scientistnobee/LightDx/caspule_board.jpeg

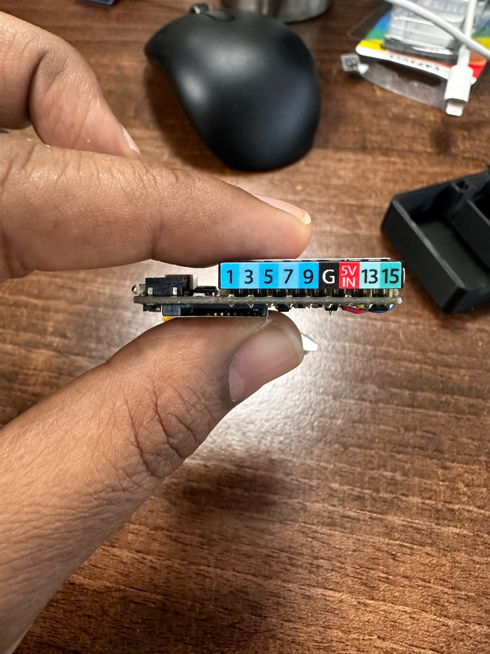
caspule_board.jpeg
