scientistnobee/LightDx/battery1.jpeg

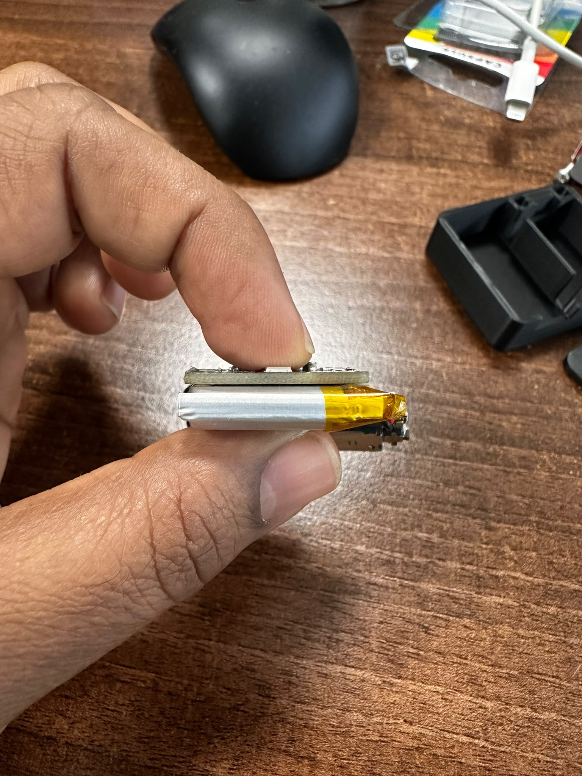
battery1.jpeg
