scientistnobee/LightDx/README.md

# LightDx
Its about wearable spectral sensor
