scientistnobee/LightDx/LightDx_slim_puck_design.html

# LightDx puck: slim, normal v4 and wearable

Design page, 2026-10-15, updated 2026-10-16: sections 6 (normal puck v4, connectors kept) and 7 (wearable strap base) are new; sections 1 to 5 describe the slim puck (second print worked well, frozen as LightDx_base_v1.FCStd, tag base-v1). Renders are FreeCAD views of the saved model Square_puck_v2.FCStd (Slim_Base, Slim_Lid); the STLs in the folder match it, and the state is committed to GitHub (tag slim-puck-print2). Heights are still the old estimates (12.7 mm total). Measurements are the user's caliper readings from 2026-10-15.

## Changes since the first print (2026-10-15, including the second-print feedback)

Item | First printed version | Current model | Why
Box length (X) | 42.4 mm | 40.4 mm | 2 mm spare along X beside the Capsule: 1 mm shaved off each end
Capsule pocket length | 40.4 mm | 38.4 mm | same; USB-C connector now pokes about 1.5 mm further into its window
Box width (Y), Capsule / battery pocket width | 50.0 / 24.4 / 20.4 mm | 50.6 / 24.4 / 21.0 mm | the 2 mm spare was in X, so the Capsule width is unchanged; the battery pocket got +0.6 mm for wires and tape
USB-C window height | centre z 5.7 mm | centre z 6.9 mm (+1.2) | connector sat higher than the window
Diffuser seat diameter | 11.2 mm | 12.0 mm | printed too small; 12.4 was then 0.4 mm too big
G42 pusher nub and tongue | nub at (18.2, 8.4) | (16.2, 10.7): 2 mm left, 3 mm up | lid photo (2 mm left, 2 mm up), then second print: 1 mm further up and a 1.5 mm shorter nub (bottom z 7.5, was 6.0)
Lid power-LED opening | round hole dia 2.0 at (15.2, 8.5) | slit 1.6 x 3.4 (long in Y) at (13.2, 10.7) | user: USB-C-like slit, centred on the tongue in Y (y 10.7, same as the nub)
Far-wall RGB LED window | y 15.2 | y 16.7, centre z 4.9 (was 3.4) | second print: 1 mm down in Y, 1.5 mm up in height (BOOT-to-RGB spacing is now 6.4 mm; 6.0 measured)
Far-wall BOOT hole | y 8.4 | y 10.3 | second print: 1 mm up in Y
Height | 12.7 mm | 12.7 mm (unchanged) | heights worked well

The second-print changes are not printed yet. Screw blocks at the X ends are now 5.75 mm wide, so a small screw head is needed (the 4.4 mm counterbore leaves about 0.7 mm to the outside). y values are in the figure frame of section 4 (box centre = 0); the printed box is drawn dashed there.

## 1. Measured parts

Part | Measured (2026-10-15) | Model used until now
Capsule board (headers incl., no shell) | 6 mm tall | 7 mm (estimate)
Battery alone | 4.5 mm | 6 mm (602025 nominal)
AS7341 board, connectors removed | 2.5 mm | 2.8 mm (pocket 3.0)
Battery + AS7341 stacked | 7 mm tall, 25 mm long, 20 mm wide | 6 + 0.5 gap + 3.0 = 9.5 tall; pocket 27.9 x 20.4

Capsule board, battery and AS7341 laid out on a table

Capsule underside (SD slot, USB-C, side switch at the end), battery and the AS7341 wired to it.

Battery and AS7341 stacked, held between two fingers

Battery + AS7341 stack seen from the side: the 7 mm figure.

Capsule board from the side with header labels

Capsule board from the side: PCB with the labelled header strip on top, SD/USB parts underneath. 6 mm overall.

## 2. Height: what the new numbers change

Left pair: the AS7341-over-battery stack (it sets the box height). Right pair: the Capsule side, which has spare depth. Clearances of 0.3 mm are proposed values, not measured.

Dimension | Built (exported STLs) | Proposed with measured parts
Total height | 12.7 mm (base 10.7 + lid 2.0) | about 10.5 mm (base 8.5 + lid 2.0)
Sensor stack under the lid | 9.5 mm (cell 6 + gap 0.5 + AS7341 pocket 3) | 7.3 mm (7.0 stack + 0.3)
Capsule pocket depth | 10.2 mm (7.0 + 3.2 spare) | 7.3 mm (6.0 + 1.3 spare)
Battery + AS7341 pocket | 27.9 x 21.0 | 25.8 x 20.4 (25 + 0.8, 20 + 0.4)
Footprint | 40.4 x 50.6 (printed 42.4 x 50.0) | 40.4 x 50.6 (proposal keeps this)

Check before rebuilding: the Adafruit AS7341 board is 25.4 mm long, slightly more than the 25 mm you measured for the stack. I would keep the pocket at 25.8 mm so the board fits either way. Not rebuilt yet: the STLs are unchanged.

## 3. Renders of the exported model

Assembled slim puck, front-left view

Assembled, 40.4 x 50.6 x 12.7 mm. Diffuser seat dia 12.0 mm; G42 button tongue and power-LED hole in the lid.

Assembled slim puck from above

Top view of the assembled box.

Base with Capsule, battery and AS7341 envelopes

Base with part envelopes: green = Capsule (40 x 24 x 7), blue = battery (27.5 x 20 x 6), orange = AS7341 board held by four lid pins above the cell.

Base from above with part envelopes

Base, plan: Capsule pocket (top), battery + AS7341 pocket (bottom), divider with the two cable notches at x = -11 and +11.

Lid from above

Lid, top: diffuser seat and the U-slot tongue over the G42 button.

Lid from below

Lid, underside: four base-screw posts, four AS7341 pillars with pins, and the button nub.

USB end of the box

USB-C end (-X): 9.4 x 3.8 mm window.

Far end of the box

Far end (+X): RGB LED window and BOOT hole (positions estimated).

## 4. Plan with X and Y axes (current model vs first print)

Looking down on the base. X runs left to right (USB end at -X, far end at +X), Y runs bottom to top (battery/AS7341 side at -Y, Capsule side at +Y). Origin is the box centre; all positions in mm. In this figure "horizontal" = X and "vertical" = Y.

## 5. Feature list and status

Feature | Value | Status
Outline, height | 40.4 x 50.6 x 12.7 mm; floor 1.2, lid 2.0, end walls 1.0, side walls 2.0 | built
Capsule pocket | 38.4 x 24.4 (battery pocket 27.9 x 21.0); USB-C connector should now stick out about 1.5 mm past the front wall (it touched the wall in the print) | built
USB-C window | 9.4 x 3.8, centre z 6.9 (raised 1.2 after the print) | height to verify
AS7341 retention | 4 lid pins, 2.0 mm, no screws | fit to verify
Diffuser seat | dia 12.0 (was 11.2, then 12.4), 1.5 deep; aperture dia 10; rim under the diffuser 0.5 thick. The diffuser is 2.0 mm thick, so it stands 0.5 mm proud of the lid; no raised ring (kept thin on purpose, to be checked with the manufacturer) | built
Divider notches | 4 mm wide at x = +11 (battery lead), -11 (I2C cable) | built
G42 button | U-slot tongue 7 x 8.9, slot 0.8, nub at (16.2, 10.7), nub bottom z 7.5 (1.5 mm shorter) | estimated
Power LED | slit 1.6 x 3.4 (long in Y) in the lid at (13.2, 10.7) (position a guess) | estimated
RGB LED (G21, side mounted) | 3.0 x 1.6 window in the far wall at y 16.7, z 4.9 | estimated
BOOT (G0, side mounted) | dia 2.4 hole in the far wall at y 10.3, z 3.0 | estimated
Base screws | 4 x M2 x 8 from below | built

## 6. Normal puck v4 (connectors kept)

For the Capsule and AS7341 with their Grove / JST connectors still fitted (not desoldered). Built by build_normal_puck_v4.py from the slim_puck script, objects V4_Base and V4_Lid. STLs: Puck_V4_Base_Strap.stl (base with strap lugs) and Puck_V4_Lid.stl. Not printed yet.

Item | Slim puck (printed) | Normal puck v4 | Origin
Outline | 40.4 x 50.6 x 12.7 mm | 43.4 x 50.0 x 16.2 mm (base 14.2, lid 2.0) | v3 was 45.4 x 50 x 16.6
Walls, floor, lid | floor 1.2, end walls 1.0, side walls 2.0, lid 2.0 | same | from slim printed fine
Diffuser seat | dia 12.0, 1.5 deep, 0.5 ledge, aperture dia 10 | same, no raised boss | from slim
AS7341 retention | 4 lid pins, no screws | same (pocket depth 4.6 for the JST connectors) | from slim
Capsule pocket | 38.4 x 24.4, height 7 | 41.4 x 24.4, height 13 | kept from v3 (Capsule with connectors)
Battery pocket | 27.9 x 21.0 | 30.4 x 20.4 | kept from v3
Cable notches and JST slots | notches x = +-11, JST slots | notches x = +-14, JST slots at both ends of the AS7341 | kept from v3
Base screws | M2 x 8 | M2 x 14 from below | base is 14.2 tall
USB-C window | 9.4 x 3.8, centre z 6.9 | 9.4 x 6.5, centre z 12.0 (assumed) | width from slim, height and z from v3
G42 tongue, nub, LED slit, BOOT, RGB | nub (16.2, 10.7); BOOT y 10.3; RGB y 16.7 | nub (17.7, 10.4); BOOT y 10.0; RGB y 16.4; z as slim (assumed) | same distances from the divider wall and 3.0 mm from the far wall; the v4 divider is 0.3 mm lower

To verify in the first print: USB window height and z, nub depth (bottom z 13.5, 0.7 mm below the Capsule top), BOOT and RGB heights, and that the Capsule sits against the far wall.

Normal puck v4 assembled with strap lugs

v4 assembled (base with lugs, lid on top), 16.2 mm tall.

v4 base from above with part envelopes

v4 base, plan: Capsule pocket (green, top), battery + AS7341 with its two JST connectors (blue / orange, bottom), four screw posts, JST slots beside the sensor.

v4 base with part envelopes, isometric

v4 base with part envelopes, isometric.

v4 lid underside

v4 lid, underside (mirrored): screw posts, AS7341 pillars with pins and the button nub, which reaches up through the 0.5 mm Capsule recess.

## 7. Wearable strap base

The puck base is the wearable base: the lugs are part of the base (no glued plate, no extra height), so the base is printed with them. Lugs are on the +-X ends and take a 20 mm watch strap with a standard 1.5 mm spring bar. The final part will be metal. Objects: Wear_Base_Strap (slim, accepted) and Wear_V4_Strap (v4), from build_wearable_mounts.py. STL exported: Wear_Base_Strap.stl and Puck_V4_Base_Strap.stl.

Item | Value | Why
Strap | 20 mm gap between the lug pairs, spring bar 1.5 mm, bar hole dia 1.8 through both lugs | user's strap is 20 mm (the Samsung strap, not 28 mm)
Lugs | 3 mm thick (Y), 6 mm tall, sticking out 6 mm from the wall (tip centre 3 mm out, radius 3), standing on the flat back (z 0 to 6) | rounded for looks and a clean strap swing
Strap position | slim: gap centre y = 1.85 (1.85 mm off-centre); v4: y = 1.55 | closest to the puck centre that keeps the lugs clear of the BOOT hole and the RGB window; exact centring would put a lug on the BOOT hole and its spring-bar seat
Upper lug | sits between the BOOT hole and the RGB window on the +X end (about 0.35 mm clear on both sides) | user accepted this
USB-C end | slim: window cut through the lug (notch above z 5); v4: window is above the lug (z 8.75 to 15.25), no notch | the lug stands in front of the window, so the strap bar is removed to plug in on the slim version
Heights | slim 12.7 mm, v4 16.2 mm (unchanged, lugs add no height); X length with lugs 52.4 (slim) / 55.4 (v4) | lugs are at the same level as the base
Back face | flat, four counterbored base-screw holes (screw heads sit recessed 2.2 mm) | diffuser and lid face outward, the flat back goes against the body

Not yet decided or built: the pocket-clip variant (Wear_Base_Clip, hidden, not exported; an arm on the back adds about 3 mm) and metal manufacturing details. Not printed or fitted yet.

Slim strap base, plan. Red = USB-C window (-X wall), blue = BOOT hole, purple = RGB window (+X wall), blue rectangles = lugs (6 mm out from the wall).

v4 strap base, plan: same layout, 3 mm longer (X) and 0.6 mm less wide (Y); features sit 0.3 mm lower in Y.

One lug in side view. The bar hole runs along Y through both lugs of a pair.

Slim strap base assembled, isometric

Slim strap base with lid, isometric.

Slim strap base seen from the back

Slim strap base, back (seen from below, mirrored): flat face, four screw counterbores, lug pairs at y = -11.15 to -8.15 and 11.85 to 14.85.

Slim strap base from above

Slim strap base, top view with lid.

Slim strap base from the front

Slim strap base from the front: round lug tips with the bar holes.

v4 strap base assembled, isometric

v4 strap base with lid, isometric.

v4 strap base seen from the back

v4 strap base, back (mirrored).

v4 strap base from above

v4 strap base, top view with lid.

v4 strap base from the front

v4 strap base from the front.

Sources: build_slim_puck.py, build_normal_puck_v4.py, build_wearable_mounts.py, LEARNINGS.md ("Enclosure: v3 and slim_puck"), memory note on the 2026-10-15 measurements. Regenerate this page with make_slim_design_page.py.
