scientistnobee/LightDx/all_together.jpeg

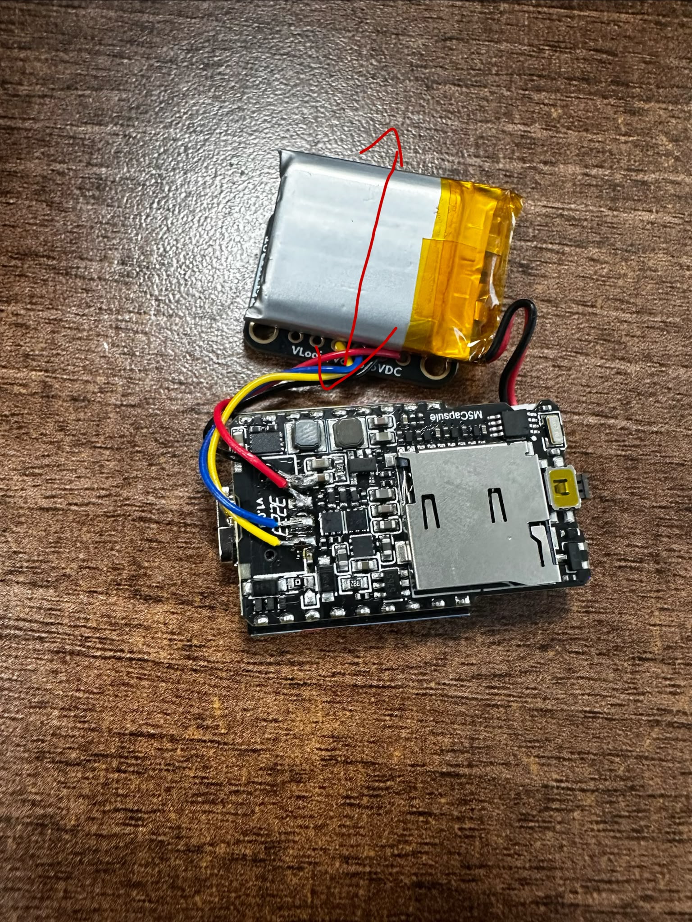
all_together.jpeg
