scientistnobee/LightDx/renders/fc_base_open_iso.png

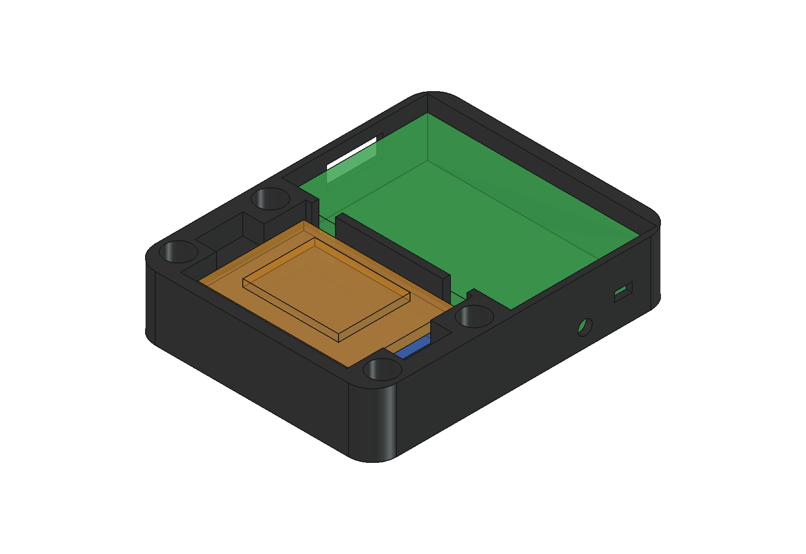
renders/fc_base_open_iso.png
