scientistnobee/LightDx/renders/fc_base_open_top.png

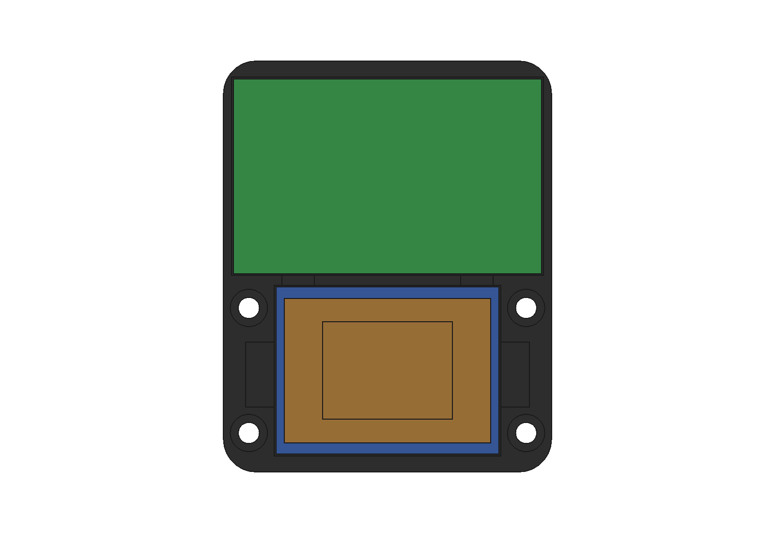
renders/fc_base_open_top.png
