scientistnobee/LightDx/renders/fc_far_end.png

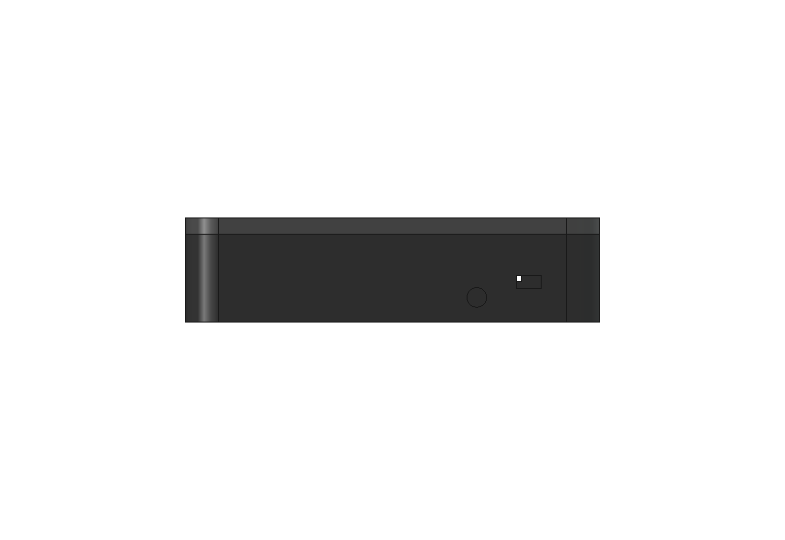
renders/fc_far_end.png
