scientistnobee/LightDx/renders/fc_lid_iso.png

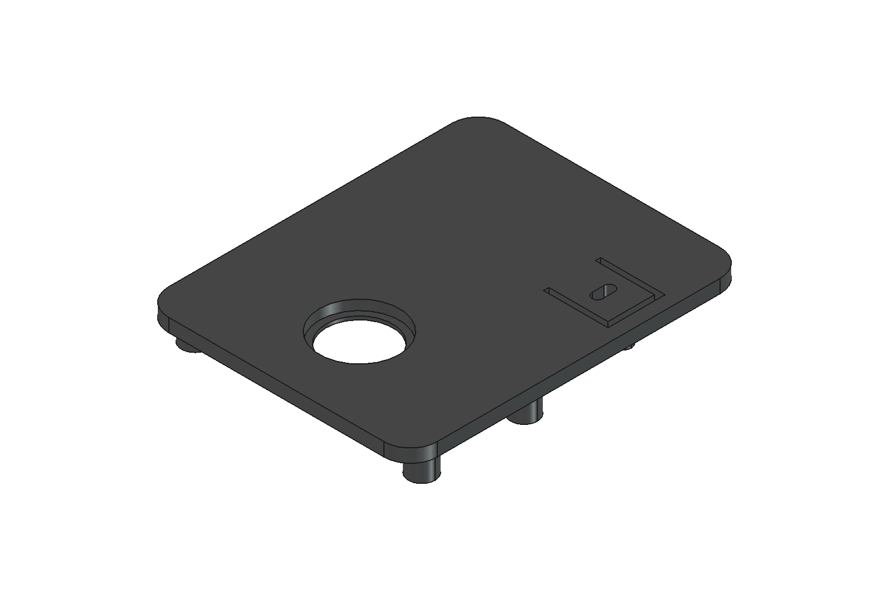
renders/fc_lid_iso.png
