scientistnobee/LightDx/renders/fc_lid_underside.png

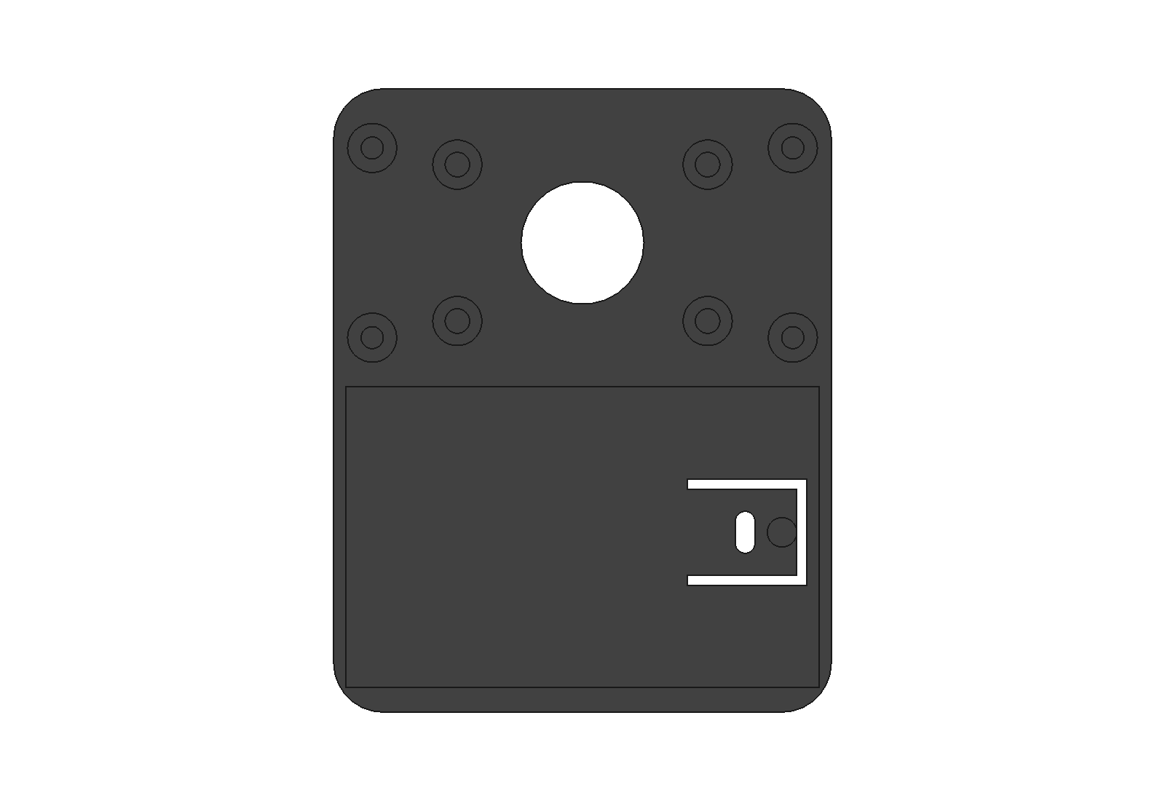
renders/fc_lid_underside.png
