scientistnobee/LightDx/renders/fc_v4_base_open_top.png

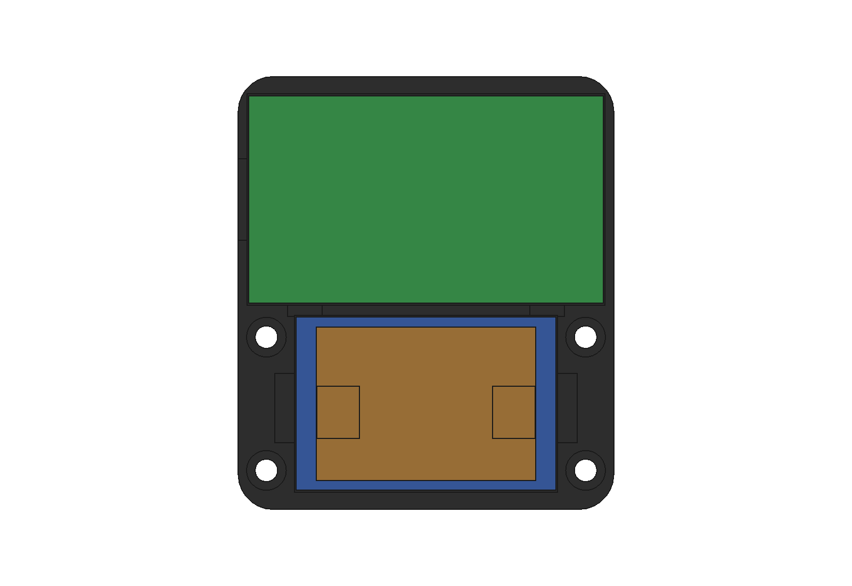
renders/fc_v4_base_open_top.png
