scientistnobee/LightDx/renders/fc_wear_slim_back.png

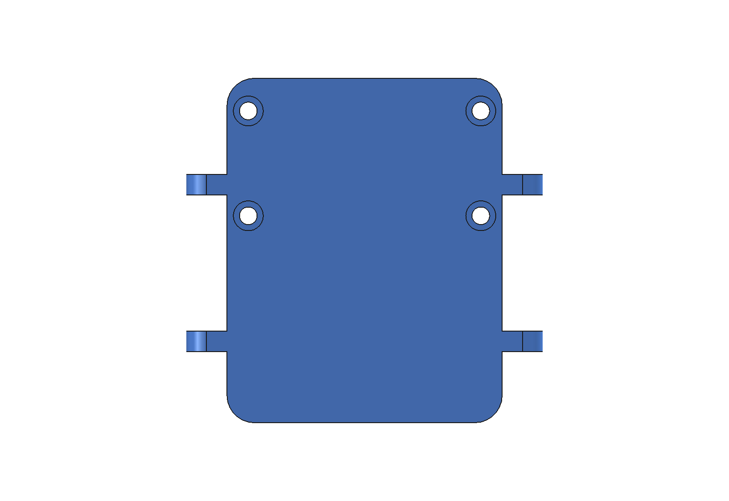
renders/fc_wear_slim_back.png
