scientistnobee/LightDx/renders/fc_wear_slim_iso.png

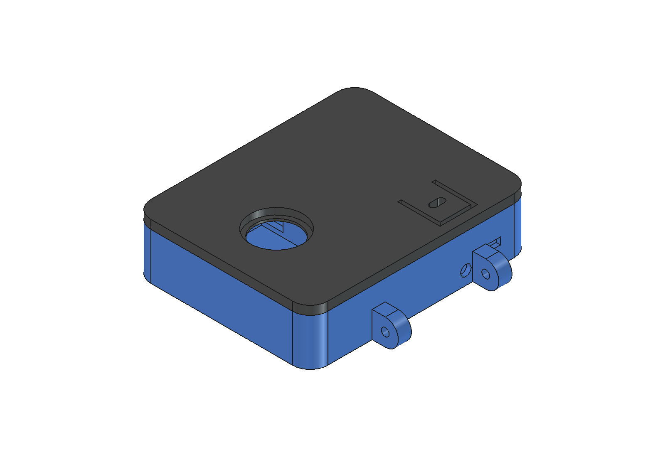
renders/fc_wear_slim_iso.png
