scientistnobee/LightDx/renders/fc_wear_slim_top.png

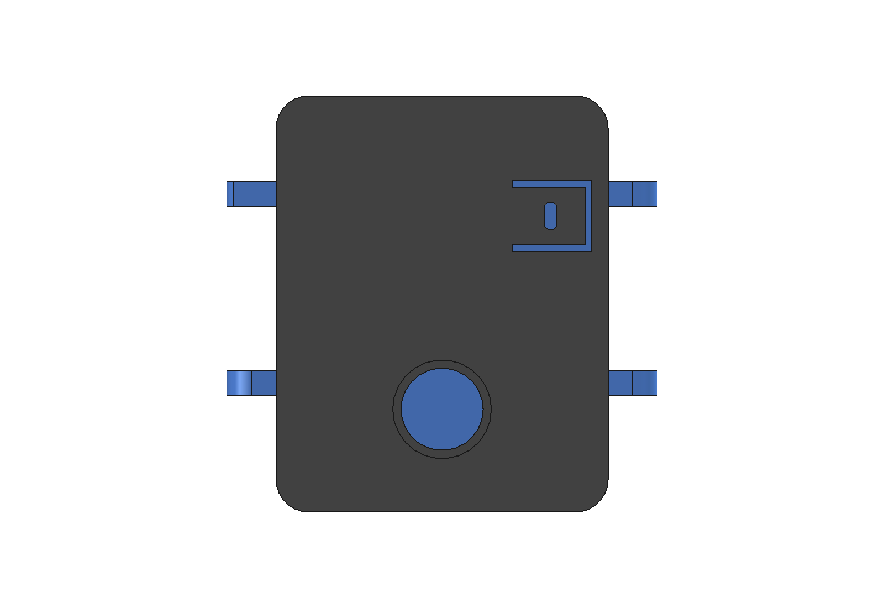
renders/fc_wear_slim_top.png
