scientistnobee/LightDx/Square_puck_v2.FCStd

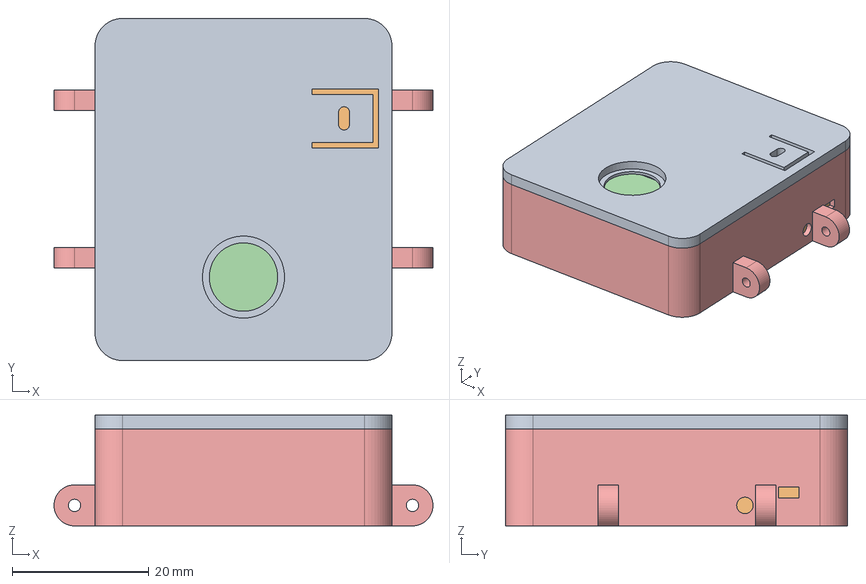
[picture p13: CAD file, 2026-10-16]
Square_puck_v2.FCStd
55.4 x 50.0 x 16.2 mm
V4 Lid
Ref V4 Capsule
Ref V4 Battery
Ref V4 AS7341
Wear_V4_Strap
