scientistnobee/LightDx/Puck_V4_Lid.stl

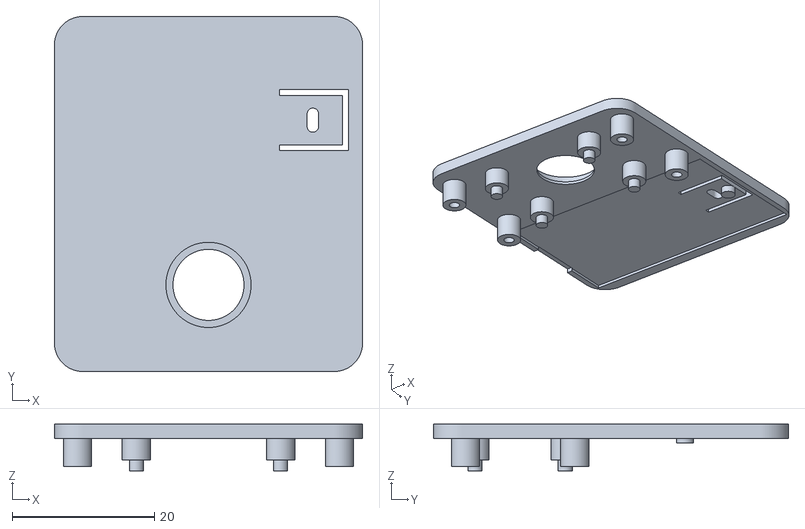
[picture p14: CAD file, 2026-10-16]
Puck_V4_Lid.stl
43.4 x 50.0 x 6.60
