scientistnobee/LightDx/Puck_V4_Base_Strap.stl

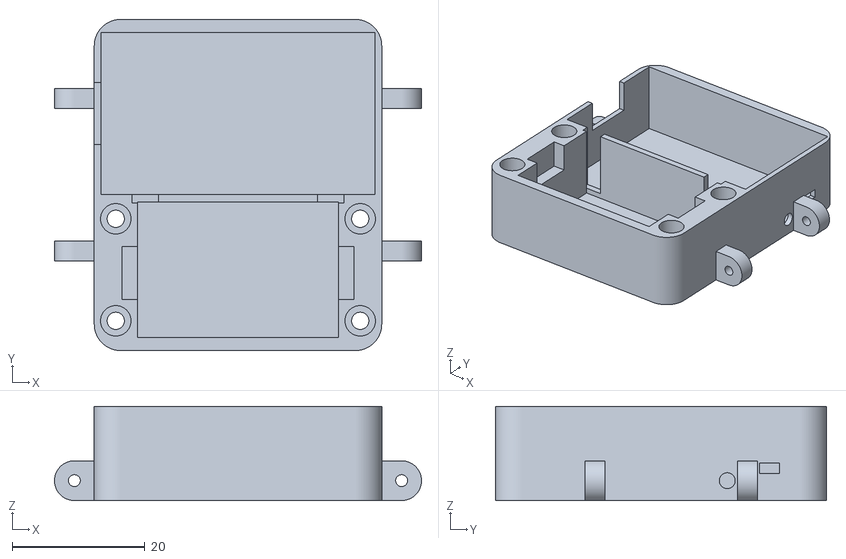
[picture p15: CAD file, 2026-10-16]
Puck_V4_Base_Strap.stl
55.4 x 50.0 x 14.2
