scientistnobee/LightDx/Wear_Base_Strap.stl

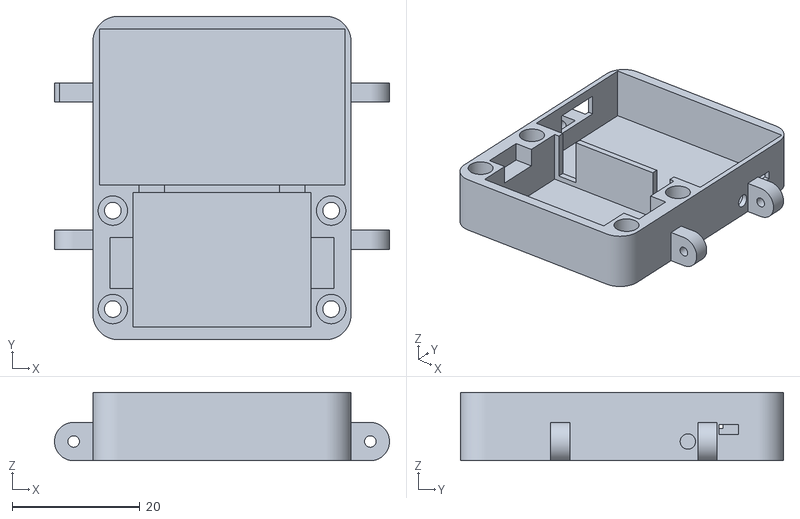
[picture p16: CAD file, 2026-10-16]
Wear_Base_Strap.stl
52.4 x 50.6 x 10.7
