scientistnobee/LightDx/LightDx_base_v1.FCStd

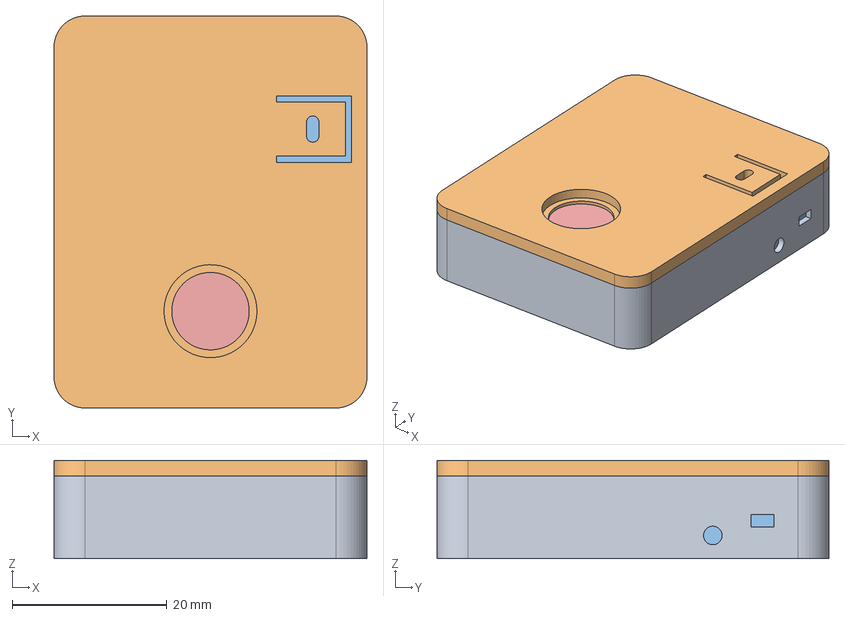
[picture p17: CAD file, 2026-10-15]
LightDx_base_v1.FCStd
40.4 x 50.6 x 12.7 mm
Slim Base
Slim Lid
Ref Slim Capsule
Ref Slim Battery
Ref Slim AS7341
