scientistnobee/LightDx/Slim_Puck_Lid.stl

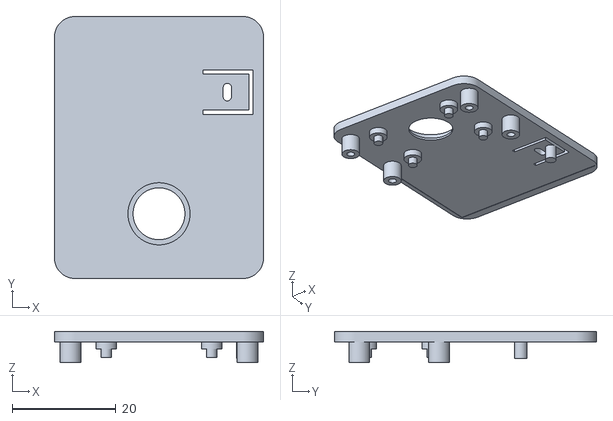
[picture p18: CAD file, 2026-10-15]
Slim_Puck_Lid.stl
40.4 x 50.6 x 6.00
