scientistnobee/LightDx/Slim_Puck_Base.stl

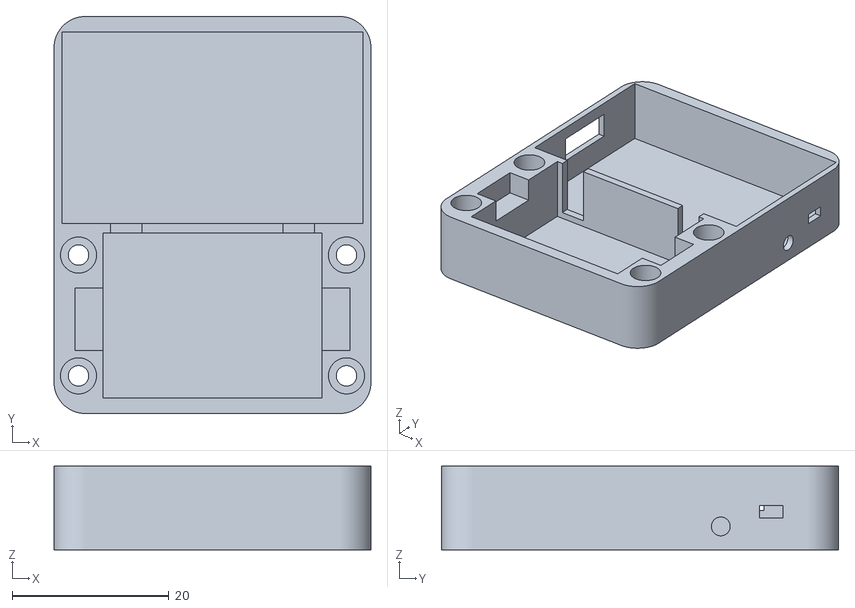
[picture p19: CAD file, 2026-10-15]
Slim_Puck_Base.stl
40.4 x 50.6 x 10.7
