scientistnobee/LightDx/m5spectrometer_cuvette.FCStd

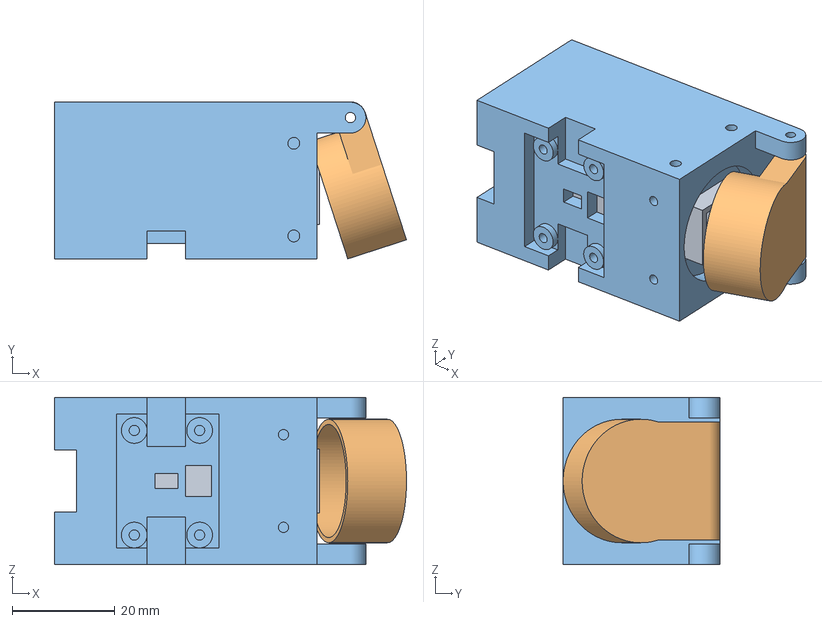
[picture p20: CAD file, 2026-10-13]
m5spectrometer_cuvette.FCStd
68.4 x 30.6 x 32.5 mm
Cuvette
m5stick_colorometer_iorodeo2_atom7_lid_only
m5stick_colorometer_iorodeo2_atom7_lid
