scientistnobee/LightDx/Puck_round.FCStd

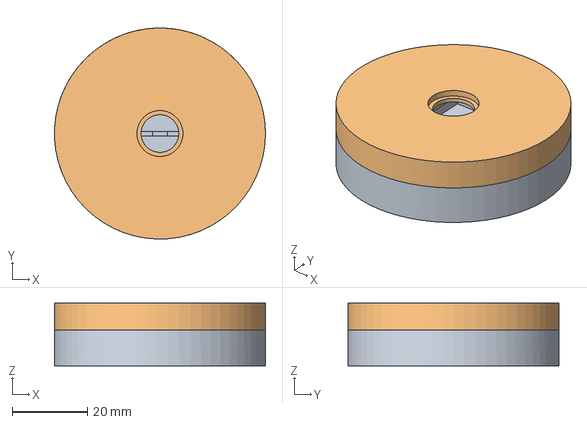
[picture p21: CAD file, 2026-10-13]
Puck_round.FCStd
56.0 x 56.0 x 16.6 mm
Puck Base
Puck Lid
