scientistnobee/LightDx/Reused_Parts.FCStd

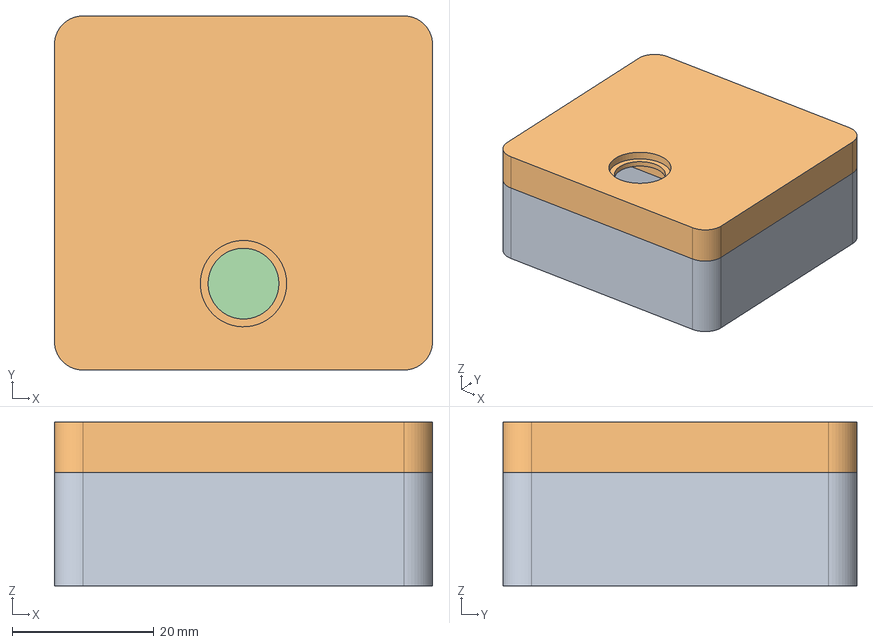
[picture p22: CAD file, 2026-10-13]
Reused_Parts.FCStd
53.4 x 50.0 x 23.1 mm
Box Base
Box Lid
Ref Capsule 40x24x14
Ref Battery 30x20x6
