scientistnobee/LightDx/Square_puck.FCStd

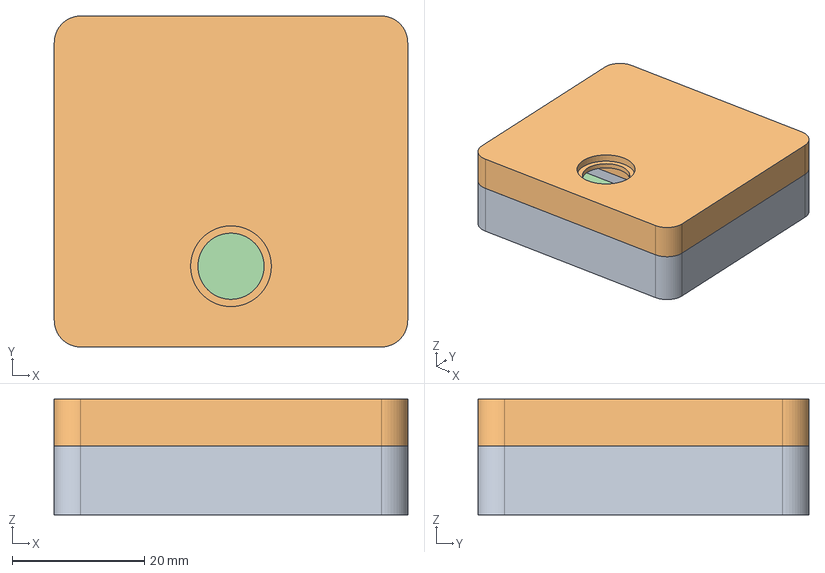
[picture p23: CAD file, 2026-10-13, an earlier design]
Square_puck.FCStd
53.4 x 50.0 x 17.5 mm
Box Base
Box Lid
Ref Capsule 40x24x14
Ref Battery 30x20x6
