scientistnobee/LightDx/(list of files, cad)

Other CAD files:
m5spectrometer_cuvette2.FCStd
