scientistnobee/LightDx/renders/fc_assembled_iso.png

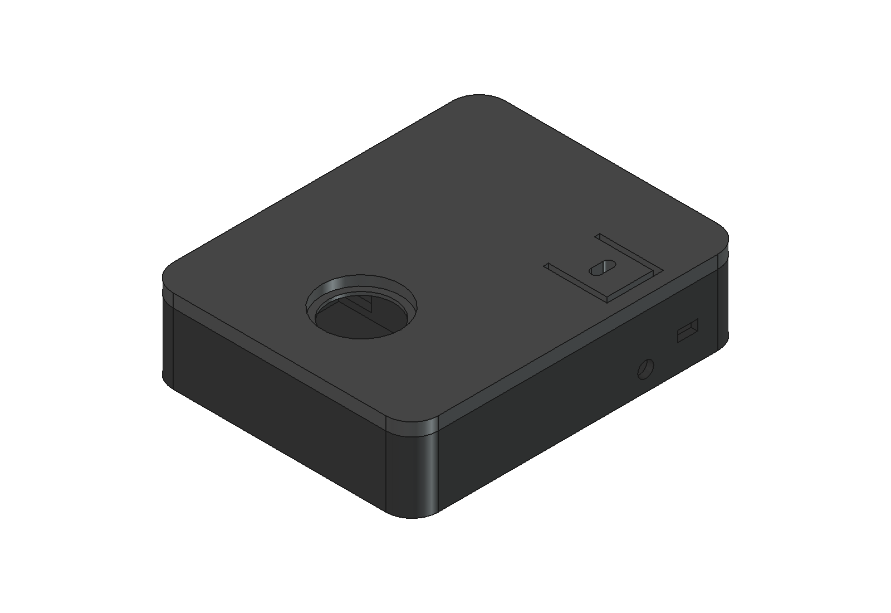
renders/fc_assembled_iso.png
