scientistnobee/LightDx/renders/fc_assembled_top.png

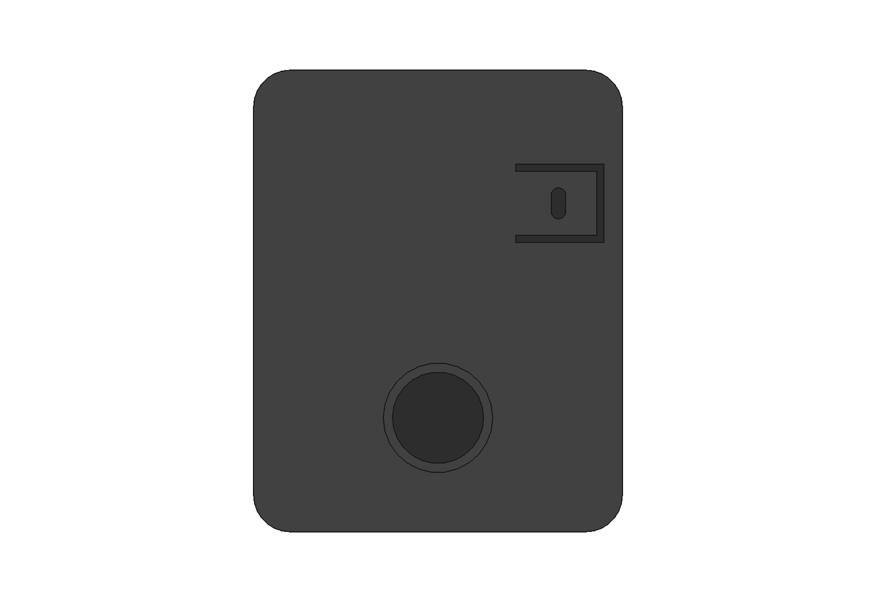
renders/fc_assembled_top.png
