scientistnobee/LightDx/(commit log)

2026-10-13 v1: LightDX Capsule AS7341 firmware, analysis scripts and FreeCAD enclosure files
    Firmware state: M5Capsule port flashed and tested; web-page upgrade (download, time, battery, SD space) compiled but not yet tested on hardware.
    [Puck_round.FCStd, Reused_Parts.FCStd, Square_puck.FCStd, Square_puck_v2.FCStd, m5spectrometer_cuvette.FCStd, m5spectrometer_cuvette2.FCStd]
2026-10-13 Add analysis input data (AS7341 response, CIE daylight basis, PpIX absorption)
    [as7341_response.csv, cie_daylight_basis.csv, ppix_absorption.csv]
2026-10-13 v1.1: web page (download, device time, battery, SD free, set-clock), non-blocking serial, no-store cache header
    Tested on hardware: 60 s row spacing, RTC agrees with uptime to 0.2 s.
2026-10-13 WIP Step 2: session recording + 60 s low-power cycle (tested, not released)
2026-10-13 WIP: daily log files, earlier buzzer pin low (compiled, untested)
    [capsule_serial_test.ino]
2026-10-14 Start closes running session with stop row; battery tile shows USB power
2026-10-15 Slim puck enclosure: second print version (40.4 x 50.6 x 12.7)
    Build script, rev history (rev1-rev18), STLs, FreeCAD file, design page
    generator and renders, measurement photos, notes.
    [Slim_Puck_Base.stl, Slim_Puck_Lid.stl, Square_puck_v2.FCStd]
2026-10-15 Design page: header text for latest print feedback
2026-10-15 LED slit centred on tongue (y 10.7); design page table layout fix
    [Slim_Puck_Lid.stl, Square_puck_v2.FCStd]
2026-10-15 Diffuser seat depth 1.5 -> 1.0 (rim under the disc 1.0 mm)
    [Slim_Puck_Lid.stl, Square_puck_v2.FCStd]
2026-10-15 Diffuser 2 mm: seat 2.0 deep, 1.0 rim, raised ring dia 16
    [Slim_Puck_Lid.stl, Square_puck_v2.FCStd]
2026-10-15 Drop raised ring; diffuser ledge back to 0.5 mm (seat 1.5 deep)
    [Slim_Puck_Lid.stl, Square_puck_v2.FCStd]
2026-10-15 Final slim puck FreeCAD file (view state)
    [Square_puck_v2.FCStd]
2026-10-16 Freeze base model LightDx_base_v1.FCStd (print 2 worked well)
    [LightDx_base_v1.FCStd]
2026-10-16 Wearable add-ons v1: strap plate (20 mm) and pocket clip plate
    [Square_puck_v2.FCStd]
2026-10-16 Wearable v2: lugs and clip merged into the puck base, rounded lugs, no glued plate
    [Square_puck_v2.FCStd]
2026-10-16 Wearable v3: lugs on the X ends, strap gap offset to y=-7 to clear windows
    [Square_puck_v2.FCStd]
2026-10-16 Wearable v4: centred strap (gap centre y=1.85), lug between BOOT and RGB
    [Square_puck_v2.FCStd]
2026-10-16 Wearable v5: keep USB-C window clear through the lug
    [Square_puck_v2.FCStd]
2026-10-16 LEARNINGS: wearable strap base accepted; centring trade-off recorded
    [Square_puck_v2.FCStd]
2026-10-16 Export Wear_Base_Strap.stl (accepted strap base)
    [Wear_Base_Strap.stl]
2026-10-16 Normal puck v4: connectors kept, slim_puck learnings applied (no STL yet)
    [Square_puck_v2.FCStd]
2026-10-16 Wearable lugs on normal puck v4 (Wear_V4_Strap)
    [Square_puck_v2.FCStd]
2026-10-16 Export normal puck v4 STLs (base with strap lugs, lid)
    [Puck_V4_Base_Strap.stl, Puck_V4_Lid.stl]
2026-10-16 Design page: add section 6 (normal puck v4) and 7 (wearable strap base), renders and figures
2026-10-16 FreeCAD file: current view state after render session
    [Square_puck_v2.FCStd]
